701lab/Battery-charging-cascade/Battery-charging-cascade/CAMOutputs/Assembly/BOM Simple Charger v.1.0.pdf

BOM Simple Charger v.1.0 | Electrical

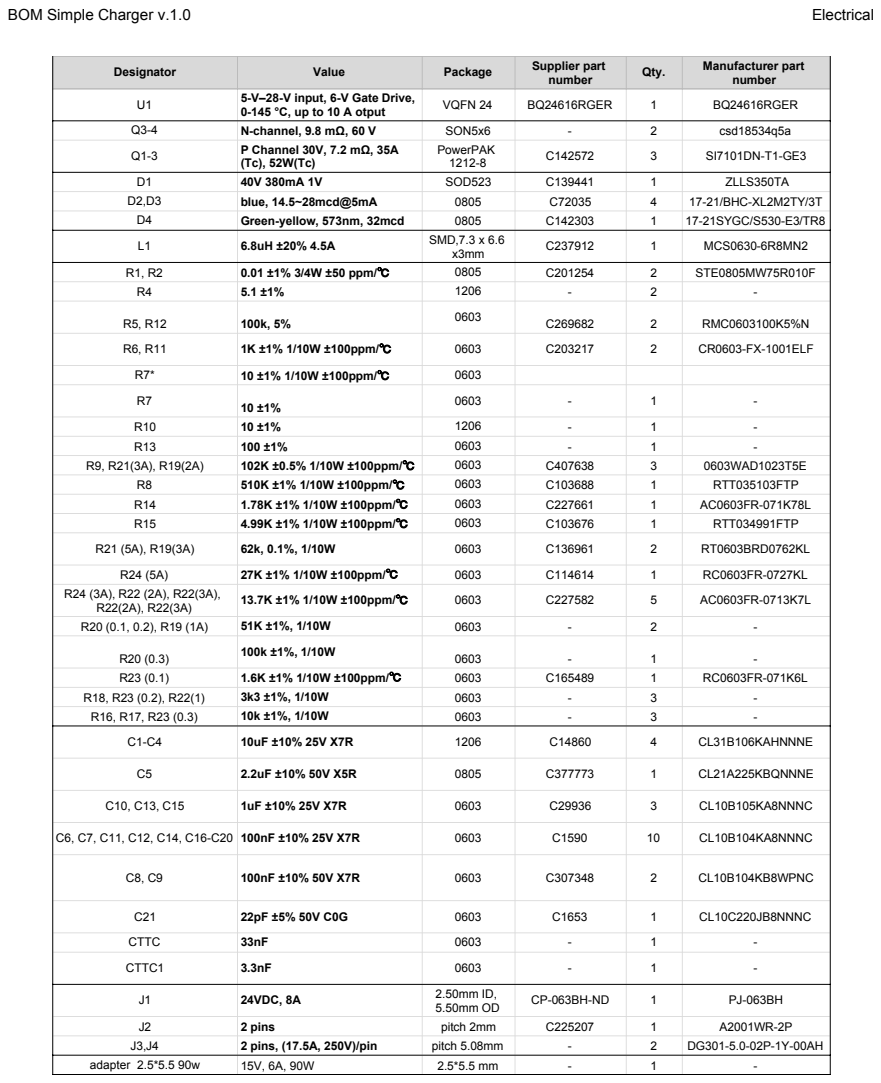
[picture p1: page 1]
