701lab/Battery-charging-cascade/Battery-charging-cascade/bq24616_battery_charger.brd

## EAGLE design Battery-charging-cascade/bq24616_battery_charger.brd (2020-05-03)

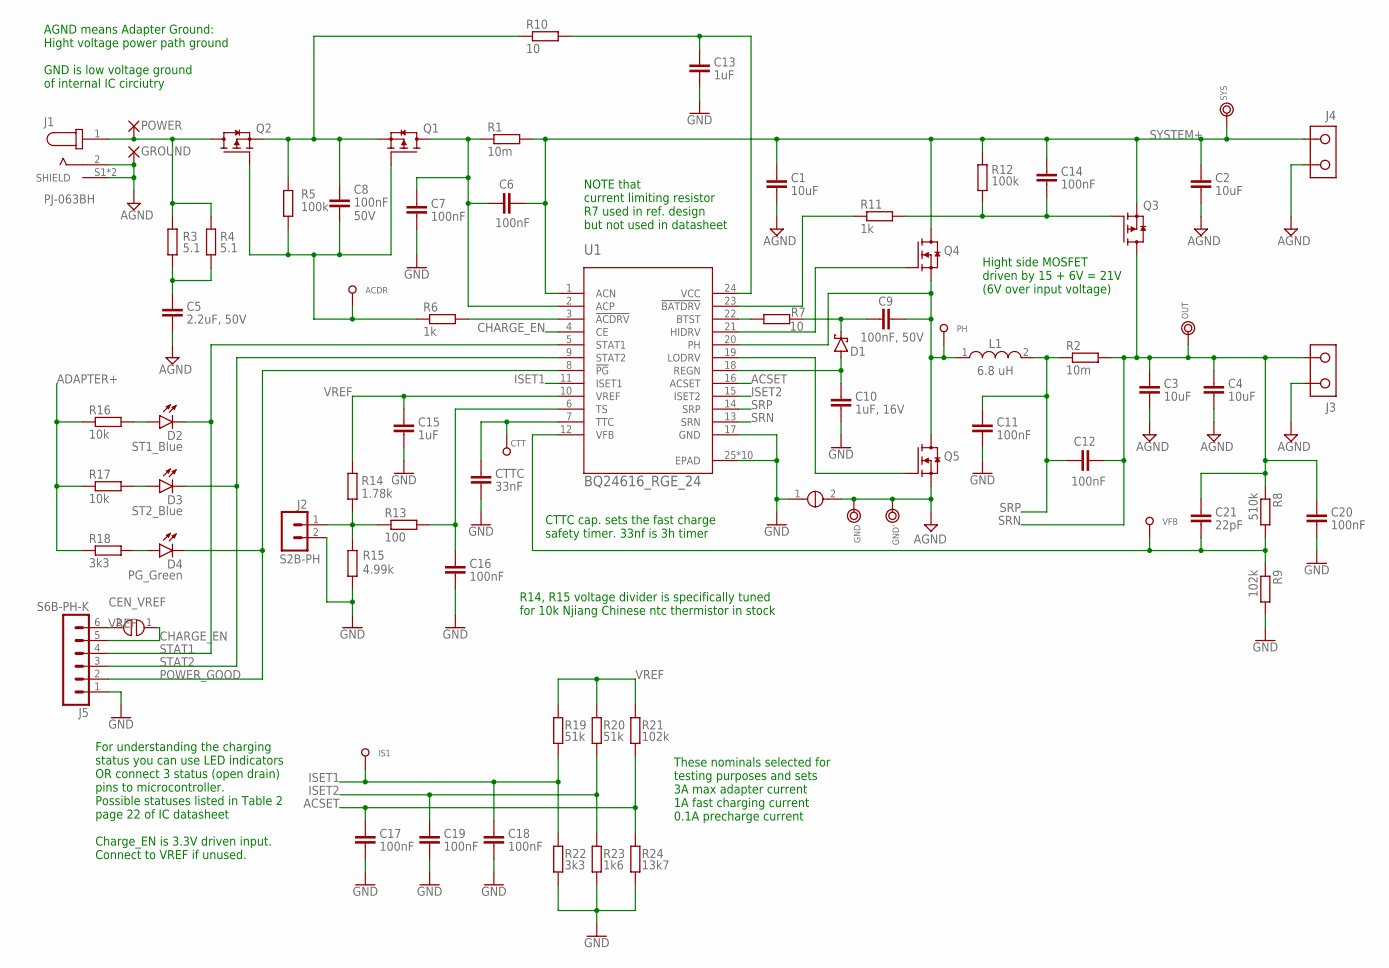
[picture p2: schematic bq24616_battery_charger.sch]

Parts:
ACDR: TEST_PAD-[1.27MM]; TP1.27MM
C1, C2, C3, C4: 10uF; C1206
C5: 2.2uF, 50V; C0805
C6, C7, C8, C11, C12, C14, C16, C17, C18, C19, C20: 100nF; C0603
C9: 100nF, 50V; C0603
C10: 1uF, 16V; C0603
C13, C15: 1uF; C0603
C21: 22pF; C0603
CEN_VREF: SOLDER_BRIDGE
CTT: TEST_PAD-[1.27MM]; TP1.27MM
CTTC: 33nF; C0603
D1: SOD523-SCHOTTKY; SOD523
D2: ST1_Blue; LED-0805
D3: ST2_Blue; LED-0805
D4: PG_Green; LED-0805
GND: TEST_RING
GND': TEST_RING
GROUND: WIRE_TO_BOARD_2,54/1,1; 2,54/1,1
IS1: TEST_PAD-[1.27MM]; TP1.27MM
J1: PJ-063BH; CUI_PJ-063BH
J2: S2B-PH; S2B-PH-K
J3, J4: DG301-2P"; DG301-2P
J5: S6B-PH-K
L1: 6.8 uH; SMD-0630
OUT: TEST_RING
PH: TEST_PAD-[1.27MM]; TP1.27MM
POWER: WIRE_TO_BOARD_2,54/1,1; 2,54/1,1
Q1, Q2, Q3: SI7121DN-T1-GE3; VISHAY_SI7121DN-T1-GE3
Q4, Q5: SON5X6_MOSFET; SON5X6
R1, R2: 10m; CS_R0805
R3, R4: 5.1; R1206
R5, R12: 100k; R0603
R6, R11: 1k; R0603
R7: 10; R0603
R8: 510k; R0603
R9, R21: 102k; R0603
R10: 10; R1206
R13: 100; R0603
R14: 1.78k; R0603
R15: 4.99k; R0603
R16, R17: 10k; R0603
R18, R22: 3k3; R0603
R19, R20: 51k; R0603
R23: 1k6; R0603
R24: 13k7; R0603
SB2: SHORT
SYS: TEST_RING
U1: BQ24616_RGE_24; RGE24_2P45X2P45
VFB: TEST_PAD-[1.27MM]; TP1.27MM

Connections:
ACDRV: R6.2, U1.3 (!ACDRV)
ACP: C6.1, C7.1, Q1.5 (D), Q1.6 (D), Q1.7 (D), Q1.8 (D), Q1.9 (D), R1.1, U1.2 (ACP)
ACSET: C17.1, R21.1, R24.2, U1.16 (ACSET)
ADAPTER+: J1.1, POWER.1, Q2.5 (D), Q2.6 (D), Q2.7 (D), Q2.8 (D), Q2.9 (D), R3.2, R4.2, R16.1, R17.1, R18.1
AGND: C1.2, C2.2, C3.2, C4.2, C5.2, GND.1, GND'.1, GROUND.1, J1.2, J1.S1 (SHIELD), J1.S2 (SHIELD), J3.1, J4.2, Q5.1 (S), Q5.2 (S), Q5.3 (S), SB2.2
BATDRV: R11.1, U1.23 (!BATDRV)
BTST: R7.1, U1.22 (BTST)
BTST1: C9.1, D1.C, R7.2
CHARGE_EN: CEN_VREF.1, J5.5, U1.4 (CE)
GATE: ACDR.1, C8.2, Q1.4 (G), Q2.4 (G), R5.2, R6.1
GND: C7.2, C10.2, C11.2, C13.2, C15.2, C16.2, C17.2, C18.2, C19.2, C20.2, CTTC.2, J2.2, J5.1, R9.2, R15.2, R22.1, R23.1, R24.1, SB2.1, U1.17 (GND), U1.25 (EPAD), U1.V (EPAD), U1.V_1 (EPAD), U1.V_2 (EPAD), U1.V_3 (EPAD), U1.V_4 (EPAD), U1.V_5 (EPAD), U1.V_6 (EPAD), U1.V_7 (EPAD), U1.V_8 (EPAD)
HIDRV: Q4.4 (G), U1.21 (HIDRV)
ISET1: C18.1, IS1.1, R19.1, R22.2, U1.11 (ISET1)
ISET2: C19.1, R20.1, R23.2, U1.15 (ISET2)
LODRV: Q5.4 (G), U1.19 (LODRV)
unnamed: C5.1, R3.1, R4.1
unnamed: C14.2, Q3.4 (G), R11.2, R12.2
unnamed: J2.1, R13.1, R14.2, R15.1
unnamed: D2.+ (A), R16.2
unnamed: D3.+ (A), R17.2
unnamed: D4.+ (A), R18.2
PH: C9.2, L1.1, PH.1, Q4.1 (S), Q4.2 (S), Q4.3 (S), Q5.5 (D), Q5.6 (D), Q5.7 (D), Q5.8 (D), Q5.9 (D), U1.20 (PH)
POWER_GOOD: D4.- (C), J5.2, U1.8 (!PG)
REGN: C10.1, D1.A, U1.18 (REGN)
SRN: C3.1, C4.1, C12.2, C20.1, C21.1, J3.2, OUT.1, Q3.5 (D), Q3.6 (D), Q3.7 (D), Q3.8 (D), Q3.9 (D), R2.2, R8.1, U1.13 (SRN)
SRP: C11.1, C12.1, L1.2, R2.1, U1.14 (SRP)
STAT1: D2.- (C), J5.4, U1.5 (STAT1)
STAT2: D3.- (C), J5.3, U1.9 (STAT2)
SYSTEM+: C1.1, C2.1, C6.2, C14.1, J4.1, Q3.1 (S), Q3.2 (S), Q3.3 (S), Q4.5 (D), Q4.6 (D), Q4.7 (D), Q4.8 (D), Q4.9 (D), R1.2, R12.1, SYS.1, U1.1 (ACN)
TCC: CTT.1, CTTC.1, U1.7 (TTC)
TS: C16.1, R13.2, U1.6 (TS)
VCC: C13.1, R10.2, U1.24 (VCC)
VCC1: C8.1, Q1.1 (S), Q1.2 (S), Q1.3 (S), Q2.1 (S), Q2.2 (S), Q2.3 (S), R5.1, R10.1
VFB: C21.2, R8.2, R9.1, U1.12 (VFB), VFB.1
VREF: C15.1, CEN_VREF.2, J5.6, R14.1, R19.2, R20.2, R21.2, U1.10 (VREF)

Notes on the sheet:
AGND means Adapter Ground: Hight voltage power path ground GND is low voltage ground of internal IC circiutry
NOTE that current limiting resistor R7 used in ref. design but not used in datasheet
Hight side MOSFET driven by 15 + 6V = 21V (6V over input voltage)
CTTC cap. sets the fast charge safety timer. 33nf is 3h timer
For understanding the charging status you can use LED indicators OR connect 3 status (open drain) pins to microcontroller. Possible statuses listed in Table 2 page 22 of IC datasheet Charge_EN is 3.3V driven input. Connect to VREF if unused.
50V
These nominals selected for testing purposes and sets 3A max adapter current 1A fast charging current 0.1A precharge current
R14, R15 voltage divider is specifically tuned for 10k Njiang Chinese ntc thermistor in stock

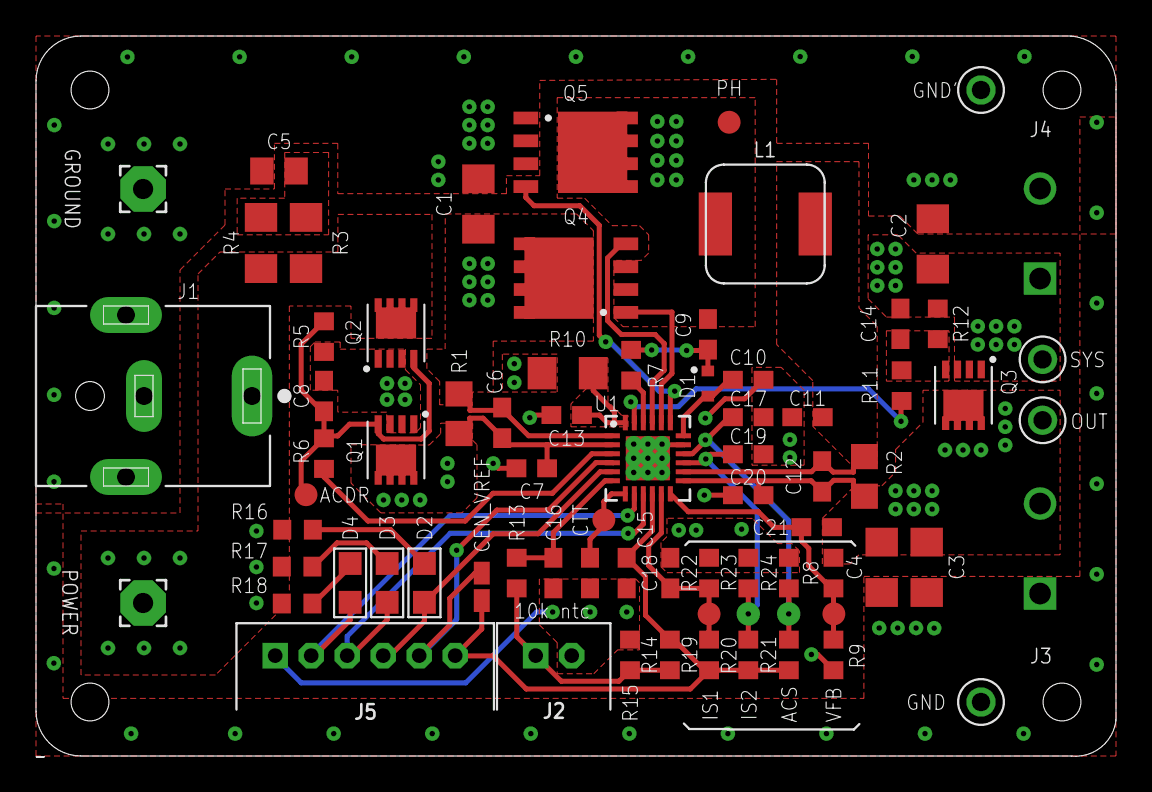
[picture p3: board bq24616_battery_charger.brd from above]

Board: 2 copper layers, 60.0 x 40.0 mm, 75 parts (1 on the bottom side), 35 nets.
