701lab/Battery-charging-cascade/Battery-charging-cascade/CAMOutputs/Assembly/assembly.pdf

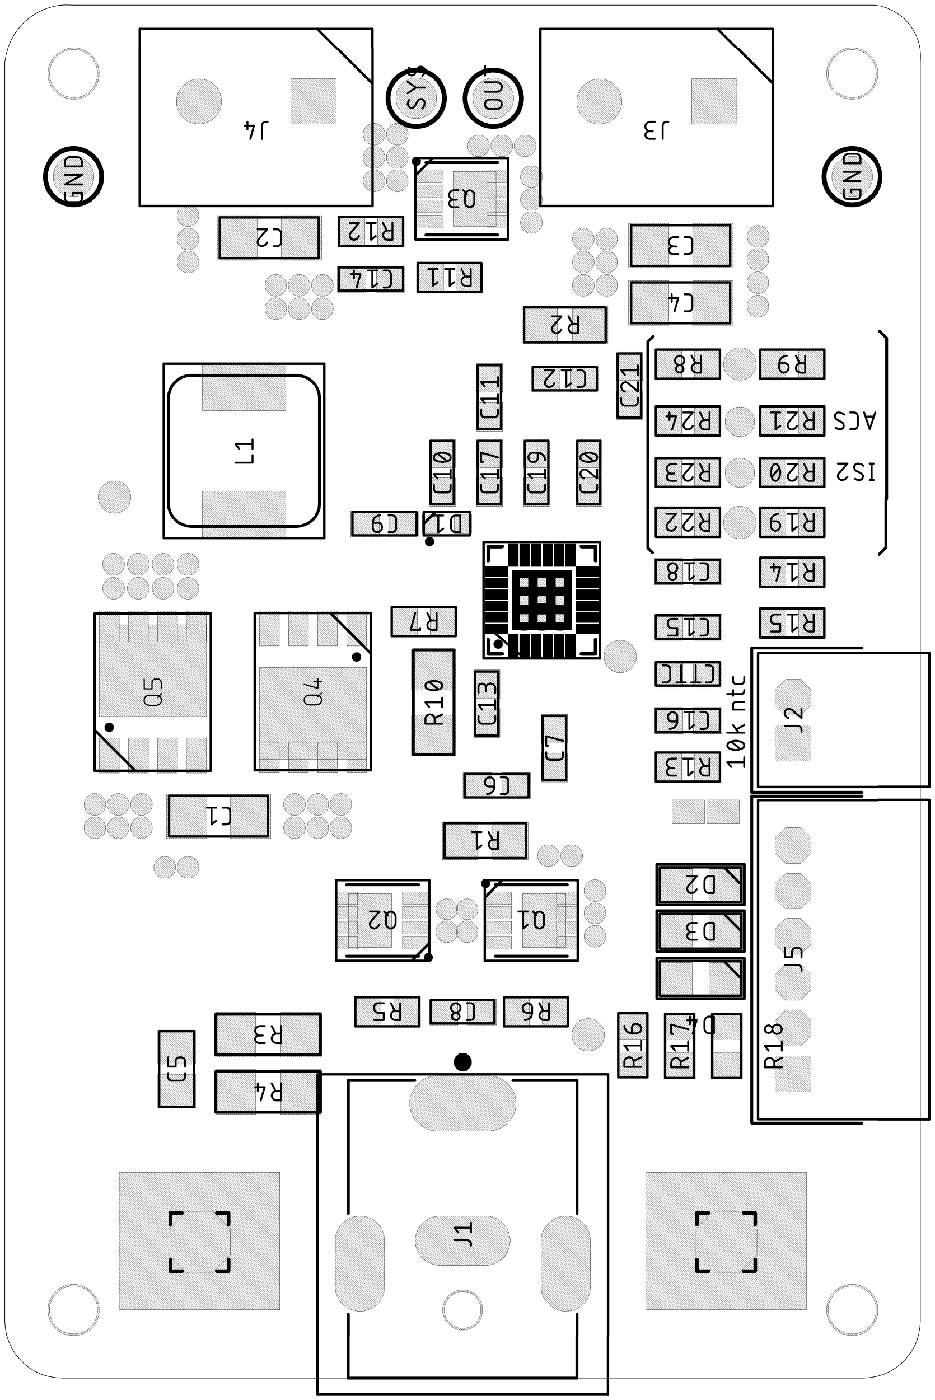
[picture p4: page 1]
