701lab/Battery-charging-cascade/(commit log)

2020-02-16 schematic witout values
    [bq24616_battery_charger.sch]
2020-02-22 schematic for review
    [bq24616_battery_charger.brd, bq24616_battery_charger.sch]
2020-02-24 final routing for rewive
    [bq24616_battery_charger.brd, bq24616_battery_charger.sch]
2020-02-25 ready to manufacturing
    [bq24616_battery_charger.brd, bq24616_battery_charger.sch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]
2020-05-03 assemble draw
    [bq24616_battery_charger.brd, bq24616_battery_charger.sch]
